AidanHockey5/Teensy_3_5_VGM_Player_YM2612_SN76489/(list of files, drawings)

Other design files:
SchematicsAndInfo/Teensy_3_5_VGM_Player.dsn
