AidanHockey5/Teensy_3_5_VGM_Player_YM2612_SN76489/SchematicsAndInfo/Teensy_3_5_VGM_Player.kicad_pcb

## KiCad design KiCad_project/air_mon1.sch

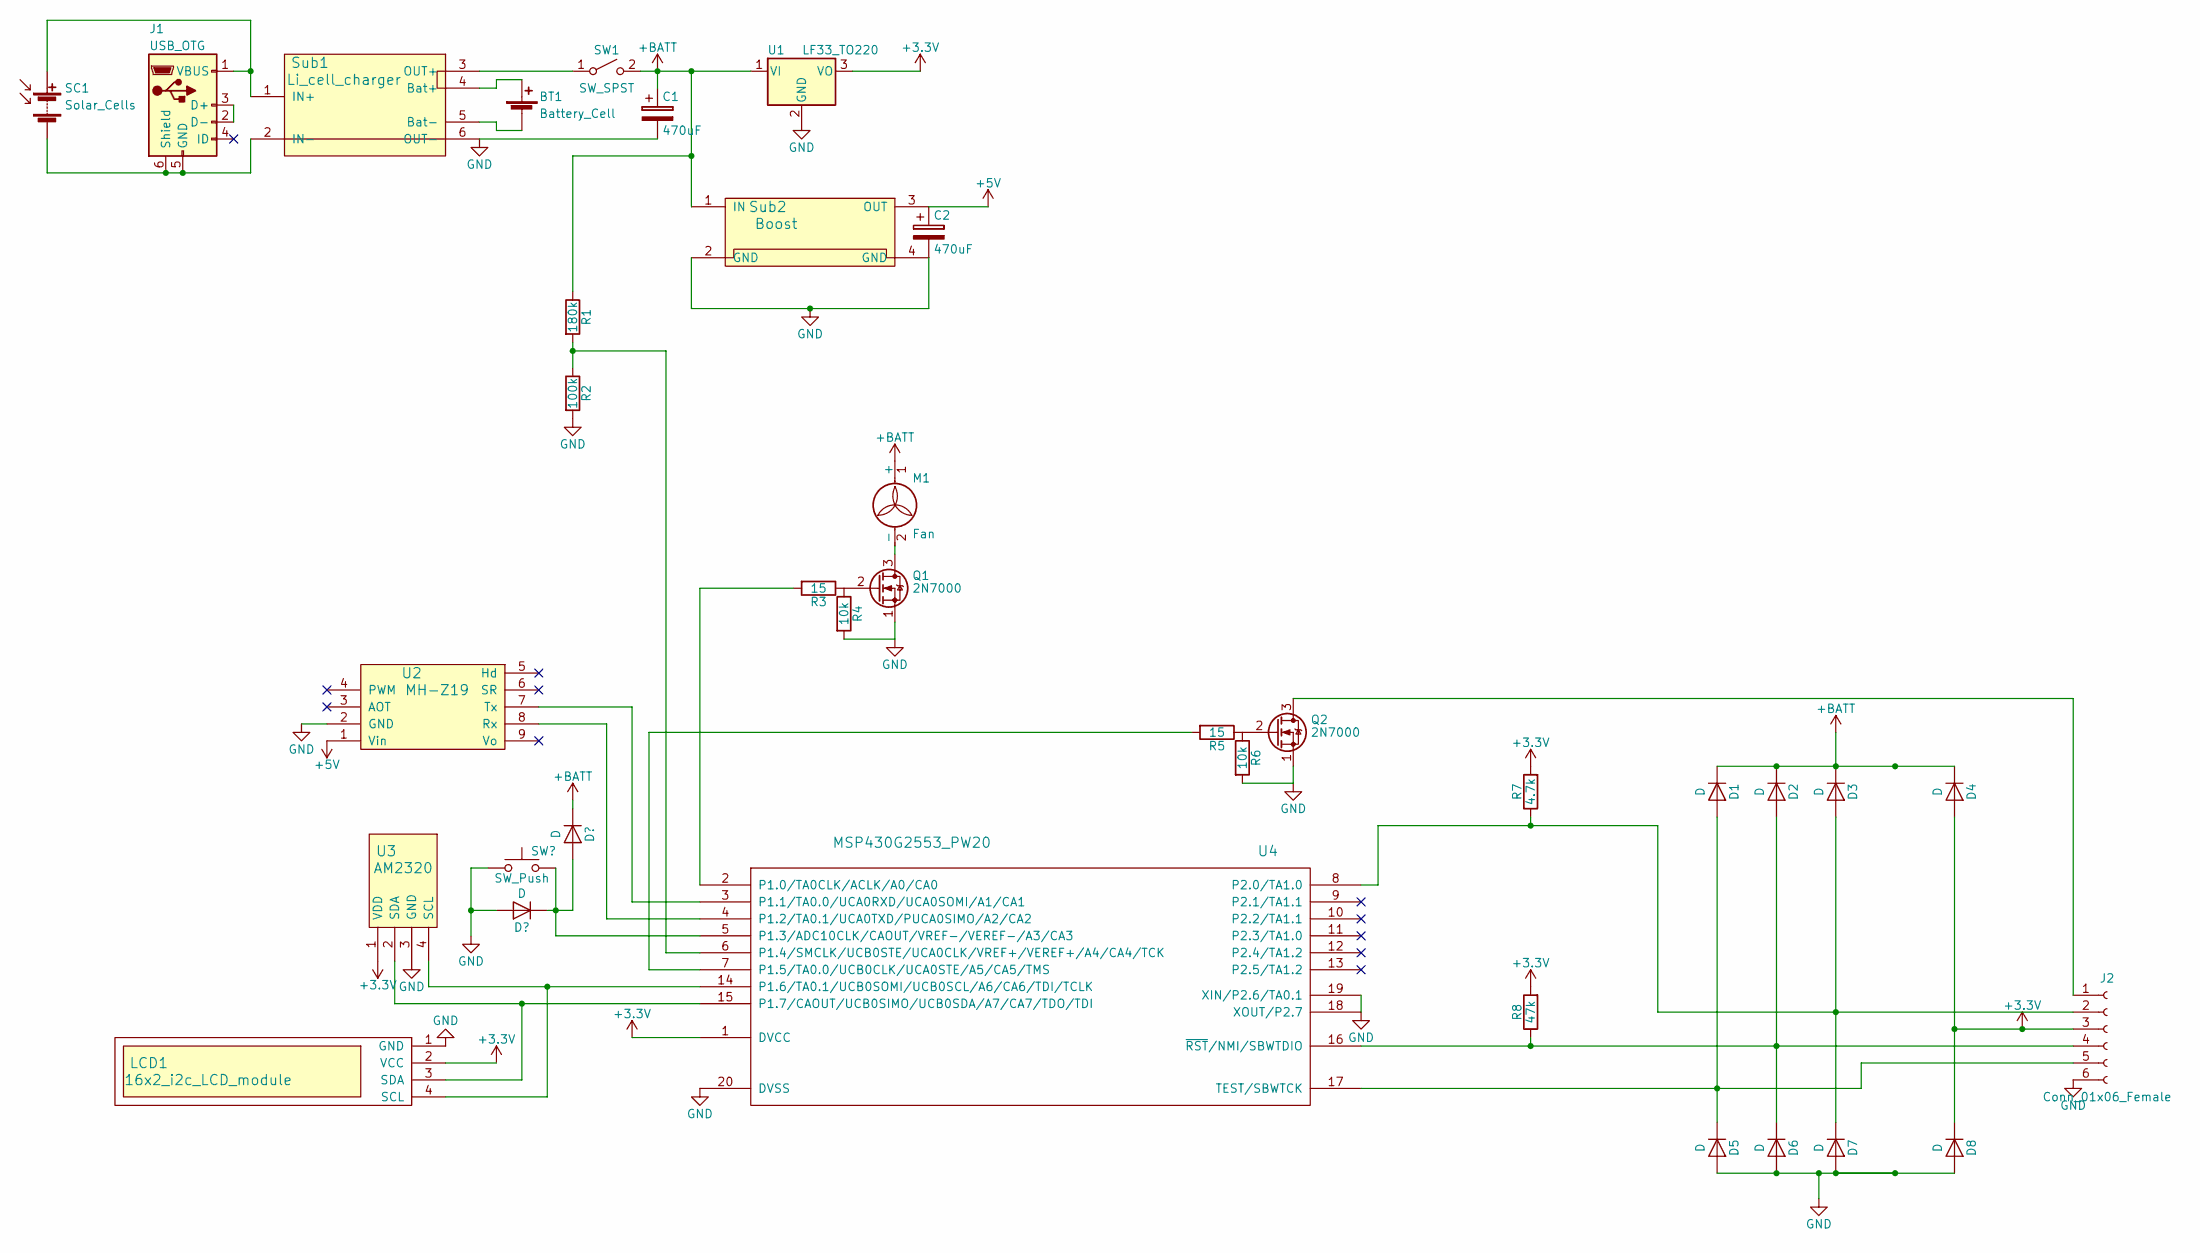
[picture p3: schematic air_mon1.sch]

Parts:
BT1: Battery_Cell
C1, C2: 470uF
D1, D2, D3, D4, D5, D6, D7, D8: D
J1: USB_OTG
J2: Conn_01x06_Female
LCD1: 16x2_i2c_LCD_module
M1: Fan
Q1, Q2: 2N7000; TO-92_Molded_Narrow
R1: 180k
R2: 100k
R3, R5: 15
R4, R6: 10k
R7: 4.7k
R8: 47k
SC1: Solar_Cells
SW1: SW_SPST
Sub1: Li_cell_charger
Sub2: Boost
U1: LF33_TO220; TO-220_Vertical
U2: MH-Z19
U3: AM2320
U4: MSP430G2553_PW20; DIP-20_W7.62mm_Socket_LongPads

Connections:
+3.3V: D4.2 (A), D8.1 (K), J2.3, LCD1.2 (VCC), R7.2, R8.2, U1.3 (VO), U3.1 (VDD), U4.1 (DVCC)
+5V: C2.1, Sub2.3 (OUT), U2.1 (Vin)
+BATT: C1.1, D1.1 (K), D2.1 (K), D3.1 (K), D4.1 (K), M1.1 (+), R1.1, SW1.2 (B), Sub2.1 (IN), U1.1 (VI)
GND: C1.2, C2.2, D5.2 (A), D6.2 (A), D7.2 (A), D8.2 (A), J2.6, LCD1.1 (GND), Q1.1 (S), Q2.1 (S), R2.2, R4.2, R6.2, Sub1.6 (OUT-), Sub2.2 (GND), Sub2.4 (GND), U1.2 (GND), U2.2 (GND), U3.3 (GND), U4.18 (XOUT/P2.7), U4.19 (XIN/P2.6/TA0.1), U4.20 (DVSS)
unnamed: BT1.1 (+), Sub1.4 (Bat+)
unnamed: BT1.2 (-), Sub1.5 (Bat-)
unnamed: D1.2 (A), D5.1 (K), J2.5, U4.17 (TEST/SBWTCK)
unnamed: D2.2 (A), D6.1 (K), J2.4, R8.1, U4.16 (~RST~/NMI/SBWTDIO)
unnamed: D3.2 (A), D7.1 (K), J2.2, R7.1, U4.8 (P2.0/TA1.0)
unnamed: J1.1 (VBUS), SC1.1 (+), Sub1.1 (IN+)
unnamed: J1.2 (D-), J1.3 (D+)
unnamed: J1.5 (GND), J1.6 (Shield), SC1.2 (-), Sub1.2 (IN-)
unnamed: J2.1, Q2.3 (D)
unnamed: LCD1.3 (SDA), U3.2 (SDA), U4.15 (P1.7/CAOUT/UCB0SIMO/UCB0SDA/A7/CA7/TDO/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)
unnamed: LCD1.4 (SCL), U3.4 (SCL), U4.14 (P1.6/TA0.1/UCB0SOMI/UCB0SCL/A6/CA6/TDI/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)
unnamed: M1.2 (-), Q1.3 (D)
unnamed: Q1.2 (G), R3.1, R4.1
unnamed: Q2.2 (G), R5.1, R6.1
unnamed: R1.2, R2.1, U4.6 (P1.4/SMCLK/UCB0STE/UCA0CLK/VREF+/VEREF+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)
unnamed: R3.2, U4.2 (P1.0/TA0CLK/ACLK/A0/CA0)
unnamed: R5.2, U4.7 (P1.5/TA0.0/UCB0CLK/UCA0STE/A5/CA5/TMS)
unnamed: SW1.1 (A), Sub1.3 (OUT+)
unnamed: U2.7 (Tx), U4.3 (P1.1/TA0.0/UCA0RXD/UCA0SOMI/A1/CA1)
unnamed: U2.8 (Rx), U4.4 (P1.2/TA0.1/UCA0TXD/PUCA0SIMO/A2/CA2)
