AidanHockey5/Teensy_3_5_VGM_Player_YM2612_SN76489/(commit log)

2017-08-25 Successful port to Teensy 3.5. Works flawlessly!
2017-08-25 Added SdFat library. Fixed header & GD3 Parsing.
    [main.cpp]
2017-08-26 Added 128x64 I2C OLED Support
2017-08-27 Added track select via file name over serial
2017-08-28 Added support for a few physical playback buttons & removed useless delays
2017-08-30 Corrected commented LTC6903 setup for YM2612
    [main.cpp]
2017-08-30 Added schematics
    [Teensy_3_5_VGM_Player.kicad_pcb, Teensy_3_5_VGM_Player.sch]
2017-09-26 Added support for bluetooth (or any other UART device) control.
2017-10-29 Added new fast GPIO writing and 10 ns delay for faster playback
    [Teensy_3_5_VGM_Player.dsn, Teensy_3_5_VGM_Player.sch]
2017-11-21 Adjusted code to accomidate changes on new prototype. Set buffer to 1 byte and noticed improved playback speed.
2017-11-21 Finished soldered prototype. Added new buttons (shuffle, loop). Changed pins
2017-11-24 Added watchdog support to reset MCU if VGM files causes crash. Changed 0x61 delays to be simpler
    [main.cpp]
2017-12-07 Updated Schematics
    [Teensy_3_5_VGM_Player.sch]
2018-03-31 Added local schematic symbols
2020-03-28 New meta file remover function to prevent crashes from system files.
    [main.cpp]
